StuyoP/Fanatec-Wheel-Barebone-Emulator/sample_wheels/FordPumaWheel.jpg

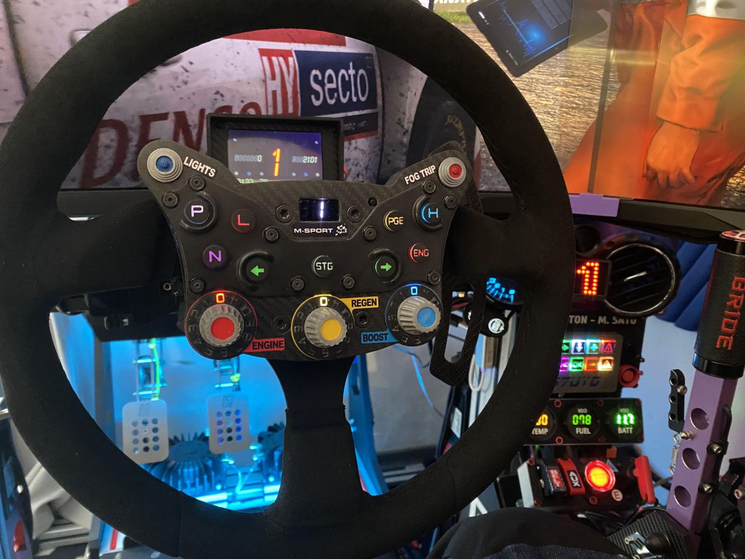
sample_wheels/FordPumaWheel.jpg
