StuyoP/Fanatec-Wheel-Barebone-Emulator/sample_wheels/PodiumHubEmu.jpg

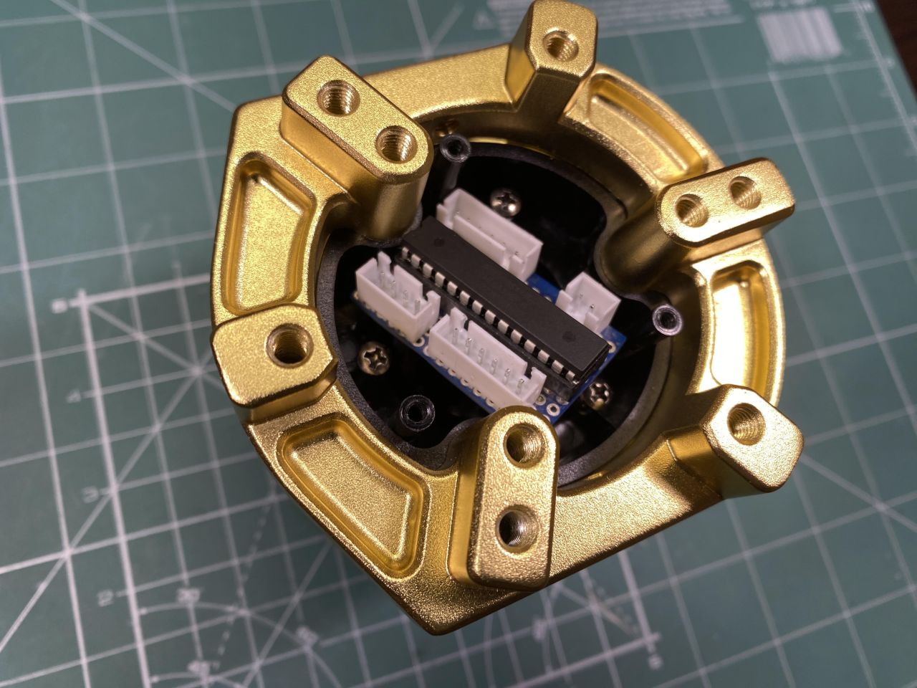
sample_wheels/PodiumHubEmu.jpg
