StuyoP/Fanatec-Wheel-Barebone-Emulator/sample_wheels/RSClioWheel.jpg

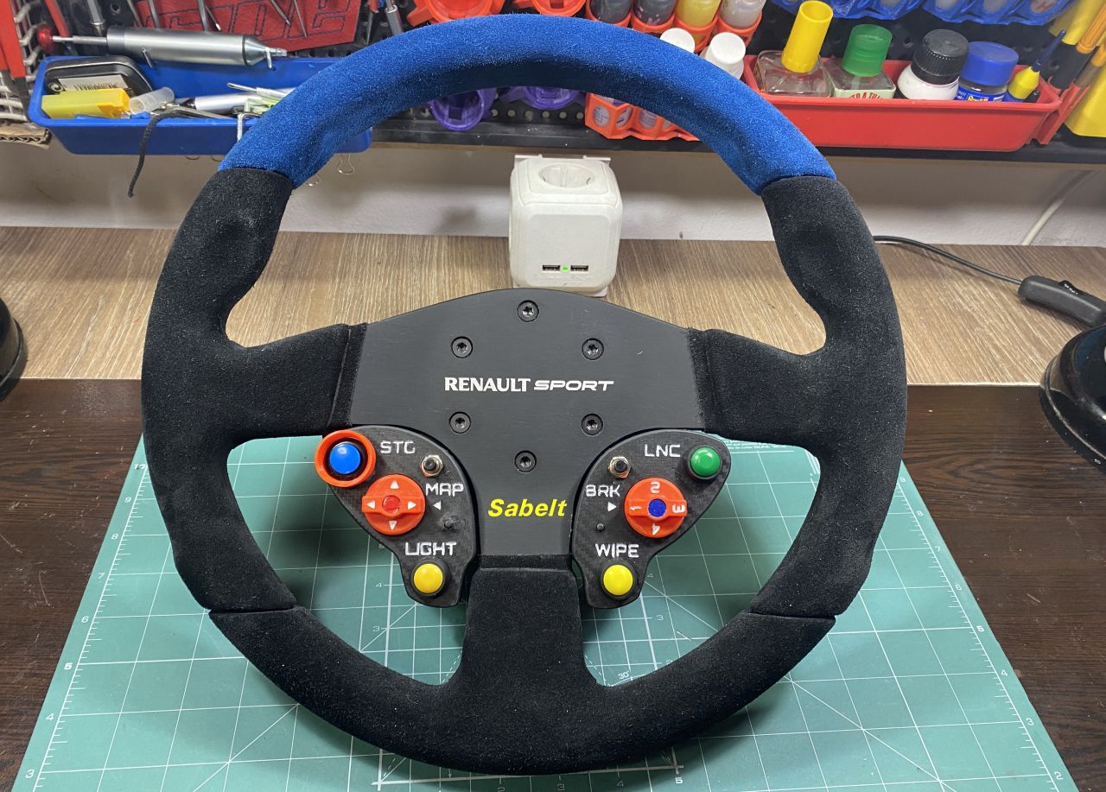
sample_wheels/RSClioWheel.jpg
