StuyoP/Fanatec-Wheel-Barebone-Emulator/(threads)

Thread 1 (2024-02-18):

CRC errors

memeticae, 2024-02-18:
Hello,

Nowhere in your code do I see anything that prevents the sending of a frame without a valid crc?
i.e.
The "loop function" can be interrupted -by spi- before it has reached the crc calculation function, therefore the frame could reflect new button states without a valid checksum.

::

I ran into this problem myself when trying to emulate a Thrustmaster SF1000 wheel, which uses a checksum as well.

If you allow the frame to be altered during an spi transaction (after each byte sent, the interrupted function resumes) , the checksum will always be wrong.
(Emanating in erroneous "DPAD-UP" events on the Thrustmaster platform)

My solution was to only calculate the checksum at the moment chip-/slaveselect went low (i.e. when the base is polling for a frame).

In my case I had to do it within 6 us, and had to revert to inline assembly to circumvent compiler "optimisations", on an atmega328p running at 8MHz internal clock, https://github.com/2v9, before sending out the next byte.

NB
From what I read in your code, you have (had) problems with CRC errors.
I think my remarks could put you in the right direction solving them.

Kind regards,
Chris

wegreenall, 2024-11-25:
Hi there - I am attempting to do a similar thing to this project.

In its current state I have the board working but it often will _start_ correctly and then fail. My guess is either that my crystal/clock is getting noise and drifting, or something like what you describe is happening. I'm running at 16Mhz at 3v3, so I imagine that it should be fast enough to avoid the inline assembly technique (the SPI of the Fanatec is apparently at 12Mhz). However, what is your suggested approach? My guess is that the checksum calculation function be called inside the "cableselect" interrupt function - is that how you would do it?

J3161, 2024-11-30:
Hi there can anyone one help me burn the bootloader from Arduino nano to atmega328pu and also show me how to transfer the project files code to the atmega328pu chip plz 😢

StuyoP, 2024-11-30:
> Hi there - I am attempting to do a similar thing to this project.
>
> In its current state I have the board working but it often will _start_ correctly and then fail. My guess is either that my crystal/clock is getting noise and drifting, or something like what you describe is happening. I'm running at 16Mhz at 3v3, so I imagine that it should be fast enough to avoid the inline assembly technique (the SPI of the Fanatec is apparently at 12Mhz). However, what is your suggested approach? My guess is that the checksum calculation function be called inside the "cableselect" interrupt function - is that how you would do it?

I had similar issue with one of my emulators, turned yo be bad wiring. Also if you add too much features on the code it starts running slowly and either buttons stop registering or SPI communication is not sent and wheelbase stops seeing wheel. Start with simpler code, make sure your emulators is working and then extend with other features like buttons, displays, etc.

Thread 2 (2024-11-16):

12 Pin JST PH plug and ATMega328p (also, THANK YOU)

wegreenall, 2024-11-16:
Hi,

first of all thank you so much for this repo, it is literally exactly what I need for what I want to do (i.e ATMega328p rather than Arduino Nano). I had seen your videos on youtube and was very impressed. I got a little lost with Ishachar's repo and this is incredible.

I note that you have have the problem with no power to the chip before power on. HOwever, my plug has the 12pin jst ph end on it(from SRM) and I can get 5 v from the USB charge +5. Are you aware of any reason this couldn't be used to power the ATMega328p without external power for startup? (Presumably this is how the real wheels do it...)

J3161, 2024-11-30:
Hi there I'm struggling to burn the bootloader and upload the files to atmega328pu is there any chance of you helping me program the chip. Thanks and god bless you

StuyoP, 2024-11-30:
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

Hi,
I do not remember if I measured the the extended 5V power supply, but the main 8pin plug one gets  switched on after the initial wheelbase boot. This means you do not have 5V before the wheelbase sees the wheel. If the extended plug 5V is still present - yeas, you can use it for power but then you need to add the level converter so it lowers signal lines going back to base to 3.3V

Powering with 3.3V does not require the level converter so this would be the simplest way to do it.
While I had Fanatec gear I was investigating using alternative chips. One obvious choice is RP2040 - this is what SRM hubs use as well. Switching to more powerful chip maybe will make this emulator work with newer Fanatec wheelbases.
